dmachard/LoRa-home/hardware/LoraHome_Gateway_v1.png

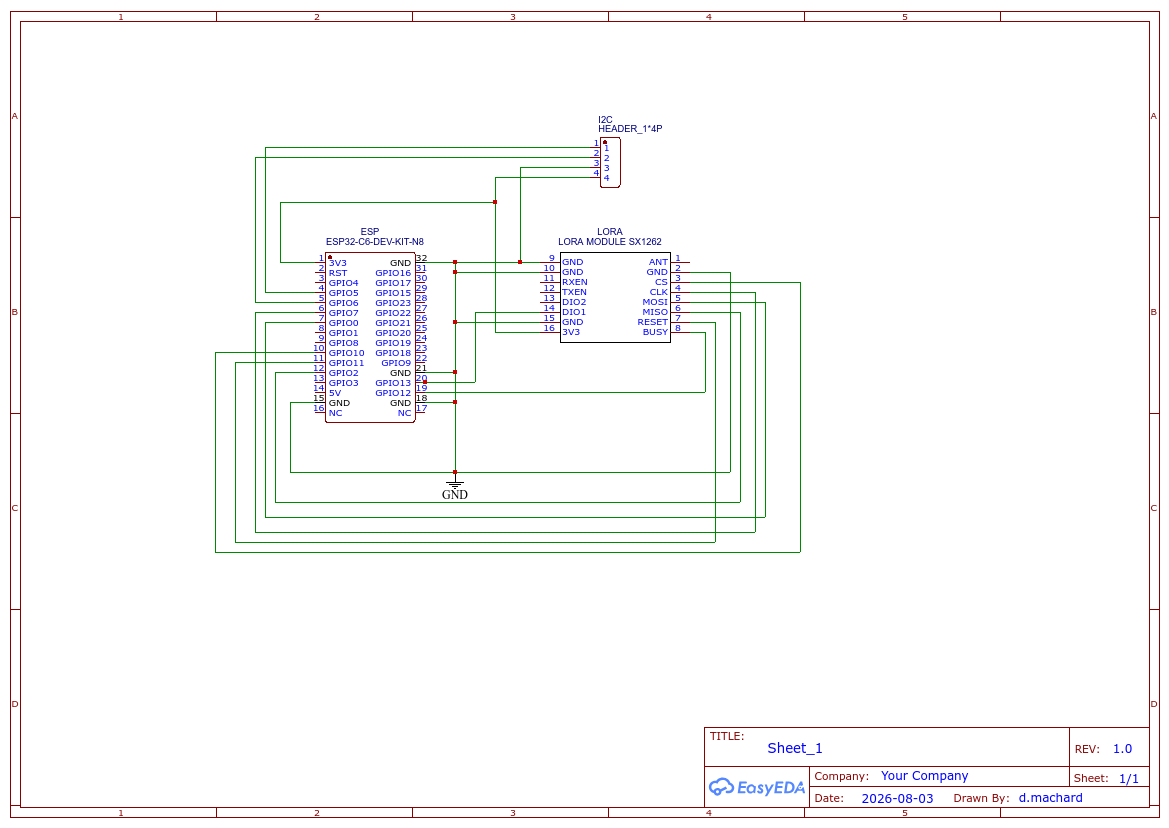
hardware/LoraHome_Gateway_v1.png
