dmachard/LoRa-home/hardware/LoraHome_Sensor_3D_v1.png

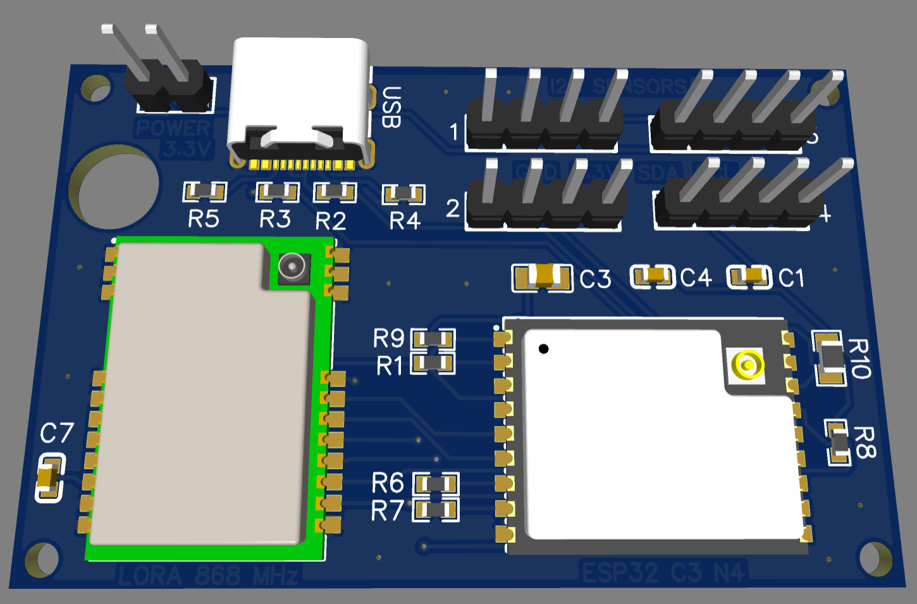
hardware/LoraHome_Sensor_3D_v1.png
