dmachard/LoRa-home/hardware/LoraHome_Sensor_v1.png

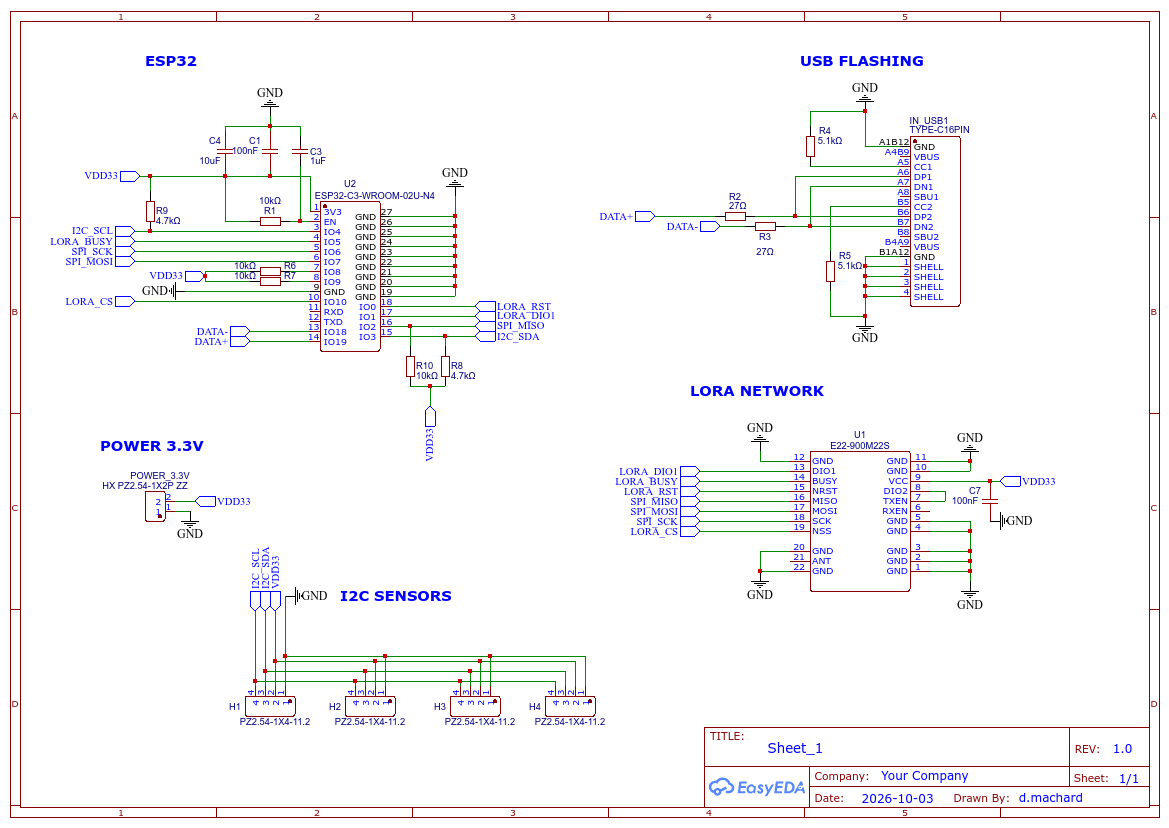
hardware/LoraHome_Sensor_v1.png
