dmachard/LoRa-home/lora-gw/config.h

#ifndef CONFIG_H
#define CONFIG_H

#include <RadioLib.h>

// ==========================================
// SYSTEM & WATCHDOG CONFIGURATION
// ==========================================
#define WDT_TIMEOUT_S 15

// ==========================================
// HARDWARE BUTTON CONFIGURATION
// ==========================================
#define BUTTON_PIN 9

// ==========================================
// I2C & OLED SCREEN CONFIGURATION
// ==========================================
#define I2C_SDA 5
#define I2C_SCL 6
#define SCREEN_WIDTH 128
#define SCREEN_HEIGHT 64
#define OLED_RESET -1
#define SCREEN_ADDRESS 0x3C

// ==========================================
// LORA PHYSICAL TRANSCEIVER CHIP & PIN CONFIG
// 1 = SX1278, 2 = SX1262
// ==========================================
#ifndef LORA_HARDWARE_CHIP
#define LORA_HARDWARE_CHIP 2
#endif

#define SPI_SCK 7
#define SPI_MISO 2
#define SPI_MOSI 0
#define LORA_CS 10
#define LORA_DIO0 1
#define LORA_DIO1 13
#define LORA_RST 11
#define LORA_BUSY 12

// ==========================================
// LORA RF CONFIGURATION
// ==========================================
#define LORA_FREQ 433.0
#define LORA_BW 125.0
#define LORA_SF 9
#define LORA_CR 5
#define LORA_POWER 14
#define LORA_PREAMBLE 8

// ==========================================
// SECURITY & PACKET SIZE CONFIGURATION
// ==========================================
#define TAG_SIZE 8
#define HDR_SIZE 9 // node_id(1) + seq(4) + random_id(4)

#endif // CONFIG_H
