dmachard/LoRa-home/lora-gw/web_server.ino

#include "index_html.h"
#include "admin_html.h"
#include "update_html.h"
#include "sw_js.h"
#include "manifest_json.h"
#include "icon_svg.h"
#include <WebServer.h>
#include <Update.h>
#include <ArduinoJson.h>

void handleMetrics() {
  String out;
  out.reserve(2048);
  out += "# HELP lora_rssi_dbm Last RSSI\n";
  out += "# TYPE lora_rssi_dbm gauge\n";
  out += "# HELP lora_snr_db Last SNR\n";
  out += "# TYPE lora_snr_db gauge\n";
  out += "# HELP lora_last_seen_seconds Seconds since last packet\n";
  out += "# TYPE lora_last_seen_seconds gauge\n";
  out += "# HELP lora_packet_seq Last sequence number\n";
  out += "# TYPE lora_packet_seq counter\n";
  out += "# HELP lora_auth_failures Total authentication failures\n";
  out += "# TYPE lora_auth_failures counter\n";
  out += "# HELP lora_reboots Total node reboots detected\n";
  out += "# TYPE lora_reboots counter\n";
  out += "# HELP lora_node_reset_reason Last ESP Reset Reason (1=POWERON)\n";
  out += "# TYPE lora_node_reset_reason gauge\n";
  out += "# HELP lora_node_error_code Node Error Code (0=OK)\n";
  out += "# TYPE lora_node_error_code gauge\n";
  out += "# HELP lora_sensor_reading Generic LoRa sensor reading\n";
  out += "# TYPE lora_sensor_reading gauge\n";
  out += "# HELP lora_global_malformed_packets_total Total malformed packets "
         "received\n";
  out += "# TYPE lora_global_malformed_packets_total counter\n";
  out += "# HELP lora_global_unknown_nodes_total Total packets from unknown "
         "node IDs\n";
  out += "# TYPE lora_global_unknown_nodes_total counter\n";
  out += "# HELP lora_global_rx_interrupts_total Total radio interrupts received\n";
  out += "# TYPE lora_global_rx_interrupts_total counter\n";
  out += "# HELP lora_global_queue_overflows_total Total queue overflows\n";
  out += "# TYPE lora_global_queue_overflows_total counter\n";
  out += "# HELP lora_global_radio_reads_total Total radio read attempts\n";
  out += "# TYPE lora_global_radio_reads_total counter\n";
  out += "# HELP lora_global_radio_errors_total Total radio read errors\n";
  out += "# TYPE lora_global_radio_errors_total counter\n";
  out += "# HELP lora_global_radio_error_code_total Radio read errors by RadioLib code\n";
  out += "# TYPE lora_global_radio_error_code_total counter\n";
  out += "# HELP lora_global_valid_packets_total Total valid packets received\n";
  out += "# TYPE lora_global_valid_packets_total counter\n";
  out += "# HELP lora_global_ack_sent_total Total ACKs transmitted by gateway\n";
  out += "# TYPE lora_global_ack_sent_total counter\n";
  out += "# HELP lora_global_rx_prep_microseconds Microseconds to release radio back to RX mode\n";
  out += "# TYPE lora_global_rx_prep_microseconds gauge\n";
  out += "# HELP lora_global_rx_total_microseconds Total packet processing time in microseconds\n";
  out += "# TYPE lora_global_rx_total_microseconds gauge\n";
  out += "# HELP lora_gateway_uptime_seconds Gateway uptime in seconds\n";
  out += "# TYPE lora_gateway_uptime_seconds gauge\n";
  out +=
      "# HELP lora_packets_received_total Total successful packets per node\n";
  out += "# TYPE lora_packets_received_total counter\n";
  out +=
      "# HELP lora_packets_lost_total Total lost packets per node\n";
  out += "# TYPE lora_packets_lost_total counter\n";
  out +=
      "# HELP lora_packets_duplicate_total Total duplicate packets received per node\n";
  out += "# TYPE lora_packets_duplicate_total counter\n";

  uint32_t now = millis();
  for (int i = 0; i < MAX_NODES; i++) {
    if (!nodes[i].seen)
      continue;
    char label[64];
    if (nodes[i].name[0] != '\0') {
      snprintf(label, sizeof(label), "{node=\"%d\",name=\"%s\"}", i, nodes[i].name);
    } else {
      snprintf(label, sizeof(label), "{node=\"%d\"}", i);
    }
    char line[128];
    snprintf(line, sizeof(line), "lora_rssi_dbm%s %.1f\n", label,
             nodes[i].rssi);
    out += line;
    snprintf(line, sizeof(line), "lora_snr_db%s %.1f\n", label, nodes[i].snr);
    out += line;
    snprintf(line, sizeof(line), "lora_last_seen_seconds%s %.1f\n", label,
             (now - nodes[i].last_seen_ms) / 1000.0f);
    out += line;
    snprintf(line, sizeof(line), "lora_packet_seq%s %lu\n", label,
             nodes[i].seq);
    out += line;
    snprintf(line, sizeof(line), "lora_auth_failures%s %lu\n", label,
             nodes[i].auth_failures);
    out += line;
    snprintf(line, sizeof(line), "lora_reboots%s %lu\n", label,
             nodes[i].reboots);
    out += line;
    snprintf(line, sizeof(line), "lora_packets_received_total%s %lu\n", label,
             nodes[i].packets_count);
    out += line;
    snprintf(line, sizeof(line), "lora_packets_lost_total%s %lu\n", label,
             nodes[i].packets_lost);
    out += line;
    snprintf(line, sizeof(line), "lora_packets_duplicate_total%s %lu\n", label,
             nodes[i].duplicate_packets);
    out += line;
    snprintf(line, sizeof(line), "lora_node_reset_reason%s %u\n", label,
             nodes[i].last_reset_reason);
    out += line;
    snprintf(line, sizeof(line), "lora_node_error_code%s %u\n", label,
             nodes[i].last_error_code);
    out += line;
    for (int j = 0; j < nodes[i].readings_count; j++) {
      char sensor_label[128];
      float val = nodes[i].readings[j].value;
      uint8_t t = nodes[i].readings[j].type;
      ReadingTypeDefinition def = getReadingDefinition(t);
      
      if (nodes[i].name[0] != '\0') {
        snprintf(sensor_label, sizeof(sensor_label), "{node=\"%d\",name=\"%s\",sensor=\"%s\"}", i, nodes[i].name, def.name);
      } else {
        snprintf(sensor_label, sizeof(sensor_label), "{node=\"%d\",sensor=\"%s\"}", i, def.name);
      }
      snprintf(line, sizeof(line), "lora_sensor_reading%s %.2f\n", sensor_label, val * def.scale);
      out += line;
    }
  }
  char global_line[128];
  snprintf(global_line, sizeof(global_line),
           "lora_global_malformed_packets_total %lu\n",
           global_malformed_packets);
  out += global_line;
  snprintf(global_line, sizeof(global_line),
           "lora_global_unknown_nodes_total %lu\n", global_unknown_nodes);
  out += global_line;
  extern uint32_t global_queue_overflows;
  extern uint32_t global_radio_reads;
  extern uint32_t global_radio_errors;
  extern uint32_t global_radio_err_crc;
  extern uint32_t global_radio_err_header;
  extern uint32_t global_radio_err_timeout;
  extern uint32_t global_radio_err_other;
  extern uint32_t global_valid_packets;
  extern uint32_t global_ack_sent_total;
  extern uint32_t global_rx_processing_us;
  extern uint32_t global_total_processing_us;
  snprintf(global_line, sizeof(global_line),
           "lora_global_rx_interrupts_total %lu\n", global_rx_interrupts);
  out += global_line;
  snprintf(global_line, sizeof(global_line),
           "lora_global_queue_overflows_total %lu\n", global_queue_overflows);
  out += global_line;
  snprintf(global_line, sizeof(global_line),
           "lora_global_radio_reads_total %lu\n", global_radio_reads);
  out += global_line;
  snprintf(global_line, sizeof(global_line),
           "lora_global_radio_errors_total %lu\n", global_radio_errors);
  out += global_line;
  snprintf(global_line, sizeof(global_line),
           "lora_global_radio_error_code_total{code=\"-7\",description=\"CRC_MISMATCH\"} %lu\n", global_radio_err_crc);
  out += global_line;
  snprintf(global_line, sizeof(global_line),
           "lora_global_radio_error_code_total{code=\"-3\",description=\"HEADER_DAMAGE\"} %lu\n", global_radio_err_header);
  out += global_line;
  snprintf(global_line, sizeof(global_line),
           "lora_global_radio_error_code_total{code=\"-6\",description=\"RX_TIMEOUT\"} %lu\n", global_radio_err_timeout);
  out += global_line;
  snprintf(global_line, sizeof(global_line),
           "lora_global_radio_error_code_total{code=\"other\",description=\"OTHER_ERRORS\"} %lu\n", global_radio_err_other);
  out += global_line;
  snprintf(global_line, sizeof(global_line),
           "lora_global_valid_packets_total %lu\n", global_valid_packets);
  out += global_line;
  snprintf(global_line, sizeof(global_line),
           "lora_global_ack_sent_total %lu\n", global_ack_sent_total);
  out += global_line;
  snprintf(global_line, sizeof(global_line),
           "lora_global_rx_prep_microseconds %lu\n", global_rx_processing_us);
  out += global_line;
  snprintf(global_line, sizeof(global_line),
           "lora_global_rx_total_microseconds %lu\n", global_total_processing_us);
  out += global_line;

  server.send(200, "text/plain; version=0.0.4; charset=utf-8", out);
}

void handleNodesJson() {
  JsonDocument doc;
  JsonArray nodes_arr = doc["nodes"].to<JsonArray>();

  uint32_t now = millis();
  for (int i = 0; i < MAX_NODES; i++) {
    if (!nodes[i].seen) continue;

    // Hide inactive nodes for more than 5 minutes
    if (now - nodes[i].last_seen_ms > 300000UL) continue;

    uint32_t total_pkts = nodes[i].packets_count + nodes[i].packets_lost;
    float loss_pct = total_pkts > 0 ? (nodes[i].packets_lost * 100.0f) / total_pkts : 0.0f;

    JsonObject node = nodes_arr.add<JsonObject>();
    node["id"]               = i;
    node["name"]             = nodes[i].name;
    node["seq"]              = nodes[i].seq;
    node["rssi"]             = nodes[i].rssi;
    node["snr"]              = nodes[i].snr;
    node["reboots"]          = nodes[i].reboots;
    node["packets_count"]    = nodes[i].packets_count;
    node["packets_lost"]     = nodes[i].packets_lost;
    node["duplicate_packets"]  = nodes[i].duplicate_packets;
    node["loss_percent"]     = loss_pct;
    node["last_reset_reason"]= nodes[i].last_reset_reason;
    node["last_error_code"]  = nodes[i].last_error_code;
    node["tx_interval"]      = nodes[i].tx_interval;
    node["elapsed_sec"]      = (now - nodes[i].last_seen_ms) / 1000;

    JsonArray readings_arr = node["readings"].to<JsonArray>();
    for (int j = 0; j < nodes[i].readings_count; j++) {
      uint8_t t   = nodes[i].readings[j].type;
      float   val = nodes[i].readings[j].value;
      ReadingTypeDefinition def = getReadingDefinition(t);

      JsonObject reading = readings_arr.add<JsonObject>();
      reading["type"]  = t;
      reading["name"]  = def.name;
      reading["label"] = def.label;
      reading["value"] = val * def.scale;
      reading["unit"]  = def.unit;
    }
  }

  extern uint8_t gw_lora_sf;
  extern float gw_lora_bw;
  extern uint8_t gw_lora_cr;
  extern uint32_t global_queue_overflows;
  extern uint32_t global_radio_reads;
  extern uint32_t global_radio_err_crc;
  extern uint32_t global_radio_err_header;
  extern uint32_t global_radio_err_timeout;
  extern uint32_t global_radio_err_other;
  JsonObject gw = doc["gateway"].to<JsonObject>();
  gw["uptime_sec"]        = millis() / 1000;
  gw["free_heap_kb"]      = ESP.getFreeHeap() / 1024;
  gw["rx_interrupts"]     = global_rx_interrupts;
  gw["queue_overflows"]   = global_queue_overflows;
  gw["radio_reads"]       = global_radio_reads;
  gw["radio_errors"]      = global_radio_errors;
  gw["radio_err_crc"]     = global_radio_err_crc;
  gw["radio_err_header"]  = global_radio_err_header;
  gw["radio_err_timeout"] = global_radio_err_timeout;
  gw["radio_err_other"]   = global_radio_err_other;
  gw["valid_packets"]     = global_valid_packets;
  gw["rx_prep_us"]        = global_rx_processing_us;
  gw["rx_total_us"]       = global_total_processing_us;
  gw["malformed_packets"] = global_malformed_packets;
  gw["unknown_nodes"]     = global_unknown_nodes;
  gw["wifi_rssi"]         = WiFi.RSSI();
  gw["reset_reason"]      = (uint8_t)esp_reset_reason();
  gw["lora_sf"]           = gw_lora_sf;
  gw["lora_bw"]           = gw_lora_bw;
  gw["lora_cr"]           = gw_lora_cr;

  extern uint8_t gwLogHead;

  extern uint8_t gwLogCount;
  extern GwLogEntry gwLogBuffer[20];

  JsonArray logs_arr = doc["logs"].to<JsonArray>();
  for (int i = 0; i < gwLogCount; i++) {
    int idx = (gwLogHead - gwLogCount + i + 20) % 20;
    JsonObject entry = logs_arr.add<JsonObject>();
    entry["t"] = gwLogBuffer[idx].timestamp_ms;
    entry["msg"] = String(gwLogBuffer[idx].message);
  }

  String out;
  out.reserve(2048);
  serializeJson(doc, out);

  server.sendHeader("Access-Control-Allow-Origin", "*");
  server.send(200, "application/json", out);
}

void handleAdminHtml() {
  if (!server.authenticate("admin", admin_pass.c_str())) {
    server.requestAuthentication(BASIC_AUTH, "LoRa Gateway Admin", "Authentication required");
    return;
  }
  server.send_P(200, "text/html", ADMIN_HTML);
}

void handleSaveConfigHttp() {
  if (!server.authenticate("admin", admin_pass.c_str())) {
    server.requestAuthentication(BASIC_AUTH, "LoRa Gateway Admin", "Authentication required");
    return;
  }
  String body = server.arg("plain");
  JsonDocument doc;
  DeserializationError err = deserializeJson(doc, body);
  if (err) {
    server.send(400, "application/json", "{\"error\":\"Invalid JSON\"}");
    return;
  }
  saveConfig(doc);
  server.sendHeader("Access-Control-Allow-Origin", "*");
  server.send(200, "application/json", "{\"status\":\"saved\"}");
  shouldReboot = true;
}

void handleResetConfigHttp() {
  if (!server.authenticate("admin", admin_pass.c_str())) {
    server.requestAuthentication(BASIC_AUTH, "LoRa Gateway Admin", "Authentication required");
    return;
  }
  Preferences tempPrefs;
  tempPrefs.begin("gw_cfg", false);
  tempPrefs.clear();
  tempPrefs.end();
  server.sendHeader("Access-Control-Allow-Origin", "*");
  server.send(200, "application/json", "{\"status\":\"reseted\"}");
  shouldReboot = true;
}

void handleGetConfigHttp() {
  if (!server.authenticate("admin", admin_pass.c_str())) {
    server.requestAuthentication(BASIC_AUTH, "LoRa Gateway Admin", "Authentication required");
    return;
  }
  JsonDocument resp;
  resp["wifi_ssid"] = wifi_ssid;
  resp["wifi_pass"] = wifi_pass;
  resp["admin_pass"] = admin_pass;
  resp["use_static"] = use_static_ip;
  resp["local_ip"] = local_IP.toString();
  resp["gateway_ip"] = gateway.toString();
  resp["subnet_mask"] = subnet.toString();
  extern uint8_t gw_lora_sync;
  extern uint8_t gw_lora_sf;
  extern float gw_lora_bw;
  extern uint8_t gw_lora_cr;
  resp["lora_chip"] = gw_lora_chip;
  resp["lora_freq"] = gw_lora_freq;
  resp["lora_sync"] = String("0x") + (gw_lora_sync < 16 ? "0" : "") + String(gw_lora_sync, HEX);
  resp["lora_sf"] = gw_lora_sf;
  resp["lora_bw"] = gw_lora_bw;
  resp["lora_cr"] = gw_lora_cr;
  
  char keyHex[33];
  for (int i = 0; i < 16; i++) {
    sprintf(keyHex + i * 2, "%02x", AES_KEY[i]);
  }
  keyHex[32] = '\0';
  resp["aes_key"] = String(keyHex);
  
  String out;
  serializeJson(resp, out);
  server.sendHeader("Access-Control-Allow-Origin", "*");
  server.send(200, "application/json", out);
}

void handleRootHtml() {
  server.send_P(200, "text/html", INDEX_HTML);
}

void handleResetStatsHttp() {
  server.sendHeader("Access-Control-Allow-Origin", "*");
  if (server.hasArg("node")) {
    int id = server.arg("node").toInt();
    if (id >= 0 && id < MAX_NODES) {
      nodes[id].reboots = 0;
      nodes[id].packets_lost = 0;
      nodes[id].packets_count = 0;
      nodes[id].auth_failures = 0;
    }
  } else {
    for (int i = 0; i < MAX_NODES; i++) {
      nodes[i].reboots = 0;
      nodes[i].packets_lost = 0;
      nodes[i].packets_count = 0;
      nodes[i].auth_failures = 0;
    }
  }
  updateDisplay();
  server.send(200, "application/json", "{\"status\":\"ok\"}");
}

void setupWebServer() {
  server.on("/admin", handleAdminHtml);
  server.on("/metrics", handleMetrics);
  server.on("/api/nodes", handleNodesJson);
  server.on("/api/gw_config", HTTP_GET, handleGetConfigHttp);
  server.on("/api/gw_config", HTTP_POST, handleSaveConfigHttp);
  server.on("/api/gw_reset", HTTP_POST, handleResetConfigHttp);
  server.on("/api/reset_stats", HTTP_POST, handleResetStatsHttp);
  server.on("/api/reset_stats", HTTP_GET, handleResetStatsHttp);
  server.on("/", handleRootHtml);

  // PWA assets
  server.on("/sw.js", []() {
    server.sendHeader("Cache-Control", "no-cache");
    server.sendHeader("Service-Worker-Allowed", "/");
    server.send_P(200, "application/javascript", SW_JS);
  });
  server.on("/manifest.json", []() {
    server.sendHeader("Cache-Control", "public, max-age=86400");
    server.send_P(200, "application/manifest+json", MANIFEST_JSON);
  });
  server.on("/icon.svg", []() {
    server.sendHeader("Cache-Control", "public, max-age=604800");
    server.send_P(200, "image/svg+xml", ICON_SVG);
  });

  // OTA upload form page
  server.on("/update", HTTP_GET, []() {
    if (!server.authenticate("admin", admin_pass.c_str())) {
      server.requestAuthentication(BASIC_AUTH, "LoRa Gateway Admin", "Authentication required");
      return;
    }
    server.sendHeader("Connection", "close");
    server.send_P(200, "text/html", UPDATE_HTML);
  });

  // POST handler for flashing
  server.on("/update", HTTP_POST, []() {
    if (!server.authenticate("admin", admin_pass.c_str())) {
      server.requestAuthentication(BASIC_AUTH, "LoRa Gateway Admin", "Authentication required");
      return;
    }
    server.sendHeader("Connection", "close");
    if (Update.hasError()) {
      server.send_P(200, "text/html", UPDATE_ERR_HTML);
    } else {
      server.send_P(200, "text/html", UPDATE_OK_HTML);
      shouldReboot = true;
    }
  }, []() {
    if (!server.authenticate("admin", admin_pass.c_str())) {
      return;
    }
    HTTPUpload& upload = server.upload();
    esp_task_wdt_reset(); // Watchdog safety during file transfer
    if (upload.status == UPLOAD_FILE_START) {
      Serial.printf("Update: %s\n", upload.filename.c_str());
      if (!Update.begin(UPDATE_SIZE_UNKNOWN)) {
        Update.printError(Serial);
      }
    } else if (upload.status == UPLOAD_FILE_WRITE) {
      if (Update.write(upload.buf, upload.currentSize) != upload.currentSize) {
        Update.printError(Serial);
      }
    } else if (upload.status == UPLOAD_FILE_END) {
      if (Update.end(true)) {
        Serial.printf("Success: %u bytes. Rebooting...\n", upload.totalSize);
      } else {
        Update.printError(Serial);
      }
    }
  });

  server.begin();
}
