dmachard/LoRa-home/lora-gw/config_manager.ino

#include <Preferences.h>
#include <ArduinoJson.h>

extern Preferences prefs;
extern String wifi_ssid;
extern String wifi_pass;
extern String admin_pass;
extern bool use_static_ip;
extern IPAddress local_IP;
extern IPAddress gateway;
extern IPAddress subnet;
extern uint8_t gw_lora_chip;
extern float gw_lora_freq;
extern uint8_t gw_lora_sync;
extern uint8_t gw_lora_sf;
extern float gw_lora_bw;
extern uint8_t gw_lora_cr;
extern uint8_t AES_KEY[16];

bool loadConfig() {
  prefs.begin("gw_cfg", false);
  bool configured = prefs.getBool("configured", false);
  
  if (configured) {
    wifi_ssid = prefs.getString("wifi_ssid", "");
    wifi_pass = prefs.getString("wifi_pass", "");
    admin_pass = prefs.getString("admin_pass", "admin");
    use_static_ip = prefs.getBool("use_static", false);
    local_IP = IPAddress(prefs.getUInt("local_ip", 0));
    gateway = IPAddress(prefs.getUInt("gateway_ip", 0));
    subnet = IPAddress(prefs.getUInt("subnet_mask", 0));
    gw_lora_chip = prefs.getUChar("lora_chip", 2);
    gw_lora_freq = prefs.getFloat("lora_freq", LORA_FREQ);
    gw_lora_sync = prefs.getUChar("lora_sync", 0x12);
    gw_lora_sf = prefs.getUChar("lora_sf", LORA_SF);
    gw_lora_bw = prefs.getFloat("lora_bw", LORA_BW);
    gw_lora_cr = prefs.getUChar("lora_cr", LORA_CR);
    prefs.getBytes("aes_key", AES_KEY, 16);
    Serial.println("Configuration loaded from NVM!");
  } else {
    Serial.println("No config in NVM. Using default values.");
  }
  prefs.end();
  return configured;
}

void saveConfig(const JsonDocument &doc) {
  prefs.begin("gw_cfg", false);
  
  if (doc.containsKey("wifi_ssid")) {
    prefs.putString("wifi_ssid", doc["wifi_ssid"].as<const char*>());
  }
  if (doc.containsKey("wifi_pass")) {
    prefs.putString("wifi_pass", doc["wifi_pass"].as<const char*>());
  }
  if (doc.containsKey("admin_pass")) {
    prefs.putString("admin_pass", doc["admin_pass"].as<const char*>());
  }
  if (doc.containsKey("use_static")) {
    prefs.putBool("use_static", doc["use_static"].as<bool>());
  }
  
  if (doc.containsKey("local_ip")) {
    IPAddress ip;
    if (ip.fromString(doc["local_ip"].as<const char*>())) {
      prefs.putUInt("local_ip", (uint32_t)ip);
    }
  }
  if (doc.containsKey("gateway_ip")) {
    IPAddress ip;
    if (ip.fromString(doc["gateway_ip"].as<const char*>())) {
      prefs.putUInt("gateway_ip", (uint32_t)ip);
    }
  }
  if (doc.containsKey("subnet_mask")) {
    IPAddress ip;
    if (ip.fromString(doc["subnet_mask"].as<const char*>())) {
      prefs.putUInt("subnet_mask", (uint32_t)ip);
    }
  }
  if (doc.containsKey("lora_chip")) {
    prefs.putUChar("lora_chip", doc["lora_chip"].as<uint8_t>());
  }
  if (doc.containsKey("lora_freq")) {
    prefs.putFloat("lora_freq", doc["lora_freq"].as<float>());
  }
  if (doc.containsKey("lora_sync")) {
    String syncStr = doc["lora_sync"] | "0x12";
    uint8_t syncVal = (uint8_t)strtol(syncStr.c_str(), NULL, 16);
    if (syncVal == 0 && syncStr != "0" && syncStr != "0x0" && syncStr != "0x00") {
      syncVal = doc["lora_sync"].as<uint8_t>();
    }
    prefs.putUChar("lora_sync", syncVal);
  }
  if (doc.containsKey("lora_sf")) {
    prefs.putUChar("lora_sf", doc["lora_sf"].as<uint8_t>());
  }
  if (doc.containsKey("lora_bw")) {
    prefs.putFloat("lora_bw", doc["lora_bw"].as<float>());
  }
  if (doc.containsKey("lora_cr")) {
    prefs.putUChar("lora_cr", doc["lora_cr"].as<uint8_t>());
  }
  
  if (doc.containsKey("aes_key")) {
    String hexStr = doc["aes_key"] | "";
    if (hexStr.length() == 32) {
      uint8_t keyBytes[16];
      for (int i = 0; i < 16; i++) {
        char bytePart[3] = { hexStr[i * 2], hexStr[i * 2 + 1], 0 };
        keyBytes[i] = (uint8_t)strtol(bytePart, NULL, 16);
      }
      prefs.putBytes("aes_key", keyBytes, 16);
    }
  }
  
  prefs.putBool("configured", true);
  prefs.end();
  Serial.println("New configuration saved to NVM!");
}

bool checkConfigMode() {
  bool configured = loadConfig();

  bool bootButtonPressed = (digitalRead(BUTTON_PIN) == LOW);

  if (!configured || bootButtonPressed) {
    inConfigMode = true;
    setupBLE(configured);
    return true;
  }
  return false;
}
