dmachard/LoRa-home/(commit log)

2026-07-16 feat: add transmission interval to sensor payload and update dashboard UI
2026-07-17 feat: generalize node readings structure to support dynamic sensor types and labels in web and display interfaces
2026-07-19 refactor: replace blocking delays with non-blocking reboot logic and optimize JSON serialization for nodes data
    [ble_manager.ino, config_manager.ino, display_manager.ino, lora-gw.ino, web_server.ino]
2026-07-19 refactor: consolidate UI styles, simplify update flow, and standardize reading labels
2026-07-19 feat: add support for SCD41 CO2 sensor across protocol, hardware, and dashboard UI
2026-07-20 refactor: remove DHT22 sensor support and internal battery voltage monitoring from project documentation and shared protocol
2026-07-20 feat: add INA226 voltage sensor support, expand sensor capacity to 10, and increase LoRa frame buffer size
2026-07-29 feat: add boot reset reason, theme toggle, and enhanced sensor data visualization to web interface
    [web_server.ino]
2026-07-29 feat: implement deep sleep power management, external wake-up button support, and persistent RTC logging for lora-nodes
2026-07-30 feat: add legend panel and refined toggle button styles to dashboard UI
2026-07-30 feat: implement Channel Activity Detection (CAD) with backoff before LoRa transmission
2026-08-01 fix: update CO2 moderate status labels to "Stuffy" and "Air Chargé" for better clarity
2026-08-05 fix: parameterize LED GPIO hold logic using LORA_DIO1 constant to support flexible pin configurations
    [lora-node.ino, lora_manager.ino]
2026-08-06 feat: include RSSI and SNR metrics in radio reception error logs
    [lora_manager.ino]
2026-08-06 feat: enable DC-DC regulator for SX1262 radios in gateway and node modules
2026-08-07 refactor: migrate LoRa packet processing to dedicated FreeRTOS task and increase I2C clock speed
2026-08-07 refactor: update localization labels, refresh pressure icon, and remove duplicate packet display in index.html
2026-08-08 feat: optimize node power consumption via single-shot sensor mode and improved sleep state handling, and reduce OTA chunk size for increased reliability.
2026-08-09 fix: improve OTA progress reporting and sensor sampling reliability for BMP280 and INA226 devices
    [lora_manager.ino]
2026-08-10 feat: track and display granular radio error statistics by RadioLib code in dashboard
    [lora-gw.ino, lora_manager.ino, web_server.ino]
2026-08-12 feat: enable PWA support with manifest and service worker, add LoRa transmission metrics, and update I2C/SPI pin configuration
2026-08-17 feat: implement adaptive LoRa transmission power based on signal strength and increase ACK timeout window.
2026-11-10 rename schematic files
